fedecastellaro/Fully-Integrated-AP-Measurer/Esquemático + PCB/BOM/BOM_PROYECTO_CASTELLARO.xls

Comment | Description | LibRef | Quantity
15nF 50V X7R | C_0805 | CAP | 1
2.7nF 50V X7R | C_0805 | CAP | 1
39nF 50V X7R | C_0805 | CAP | 2
10uF 6.3V X7R | C_0805 | CAP | 5
100nF 50V X7R | C_0805 | CAP | 8
10nF 50V X7R | C_0805 | CAP | 1
18pF 50V COG | C_0805 | CAP | 2
100nF 50V X7R | C_0805 | CAP | 7
68k 5% | R_0805 | RES | 2
27k 5% | R_0805 | RES | 3
56k 5% | R_0805 | RES | 1
100k 5% | R_0805 | RES | 3
10k 5% | R_0805 | RES | 2
100k 5% | Preset | RPot SM | 2
4k7 5% | R_0805 | RES | 1
1k 5% | R_0805 | RES | 3
10k 5% | R_0805 | RES | 7
100 5% | R_0805 | RES | 1
Green Led | LED_0805 | LED | 1
LM324AM/NOPB | SOI8 | LM358M | 1
LM324AM/NOPB | SOIC14 | LM324M | 1
AD620ARZ | SOI8 | AD620 | 1
LPC1769FBD100 | LQFP100 | LPC1768FBD100 | 1
TL7660CD | SOI8 | TL7660 | 1
TPS73733DCQ | SOT-223-4 | TLV1117-33CKVURG3 | 1
ABM3C-12.000MHZ-D4Y-T | ABM3C | ABM3_CRISTAL | 1
Conector IDC MACHO VERTICAL 2x5 | Conector_TFT | Conector | 1
