fedecastellaro/Fully-Integrated-AP-Measurer/(list of files, cad)

Other CAD files:
Esquemático + PCB/Datasheets/2.2S/51-keil-Demo/Basic_scrap_r test/main.OBJ
Esquemático + PCB/Datasheets/2.2S/51-keil-Demo/Integrated_Test_requires_more_than_16K_ROM_MCU/Integrated_Test_requires_more_than_16K_ROM_MCU/main.OBJ
Esquemático + PCB/Datasheets/2.2S/51-keil-Demo/Basic_scrap_r test/font.obj
Esquemático + PCB/Datasheets/2.2S/51-keil-Demo/Integrated_Test_requires_more_than_16K_ROM_MCU/Integrated_Test_requires_more_than_16K_ROM_MCU/font.obj
Esquemático + PCB/Datasheets/2.2S/51-keil-Demo/Basic_scrap_r test/LCD.obj
Esquemático + PCB/Datasheets/2.2S/51-keil-Demo/Integrated_Test_requires_more_than_16K_ROM_MCU/Integrated_Test_requires_more_than_16K_ROM_MCU/LCD.obj
Esquemático + PCB/Datasheets/2.2S/51-keil-Demo/Basic_scrap_r test/touch.obj
Esquemático + PCB/Datasheets/2.2S/51-keil-Demo/Integrated_Test_requires_more_than_16K_ROM_MCU/Integrated_Test_requires_more_than_16K_ROM_MCU/sys.obj
Esquemático + PCB/Datasheets/2.2S/51-keil-Demo/Basic_scrap_r test/sys.obj
Esquemático + PCB/Datasheets/2.2S/51-keil-Demo/Integrated_Test_requires_more_than_16K_ROM_MCU/Integrated_Test_requires_more_than_16K_ROM_MCU/touch.obj
Esquemático + PCB/Datasheets/2.2S/51-keil-Demo/Basic_scrap_r test/STARTUP.OBJ
Esquemático + PCB/Datasheets/2.2S/51-keil-Demo/Integrated_Test_requires_more_than_16K_ROM_MCU/Integrated_Test_requires_more_than_16K_ROM_MCU/STARTUP.OBJ
