fedecastellaro/Fully-Integrated-AP-Measurer/Esquemático + PCB/TDII_ANALOG_R00.pdf

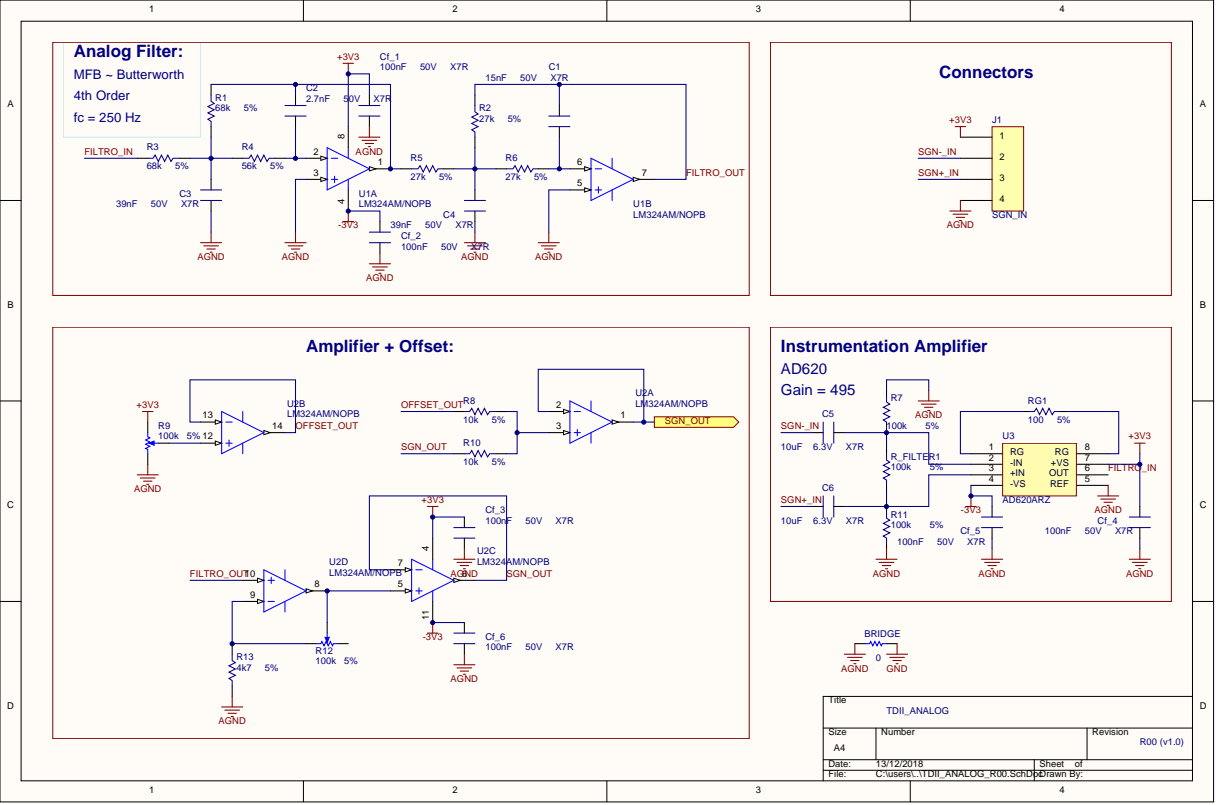
[picture p51: page 1]
