fedecastellaro/Fully-Integrated-AP-Measurer/(list of files, drawings)

Other design files:
Esquemático + PCB/TDII_ANALOG_R00.SchDoc
Esquemático + PCB/TDII_Bloques_R00.SchDoc
Esquemático + PCB/TDII_BT_R00.SchDoc
Esquemático + PCB/TDII_CPU_R00.SchDoc
Esquemático + PCB/TDII_PCB(backup)_R00.PcbDoc
Esquemático + PCB/TDII_PCB_LIB_R00.PcbLib
Esquemático + PCB/TDII_PCB_R00.PcbDoc
Esquemático + PCB/TDII_PROYECT_R00.PrjPcb
Esquemático + PCB/TDII_PWR(BackUp)_R00.SchDoc
Esquemático + PCB/TDII_PWR_R00.SchDoc
Esquemático + PCB/TDII_SCH_LIB_R00.SchLib
Esquemático + PCB/TDII_TFT_R00.SchDoc
Esquemático + PCB/TDII_WIFI_R00.SchDoc
