fedecastellaro/Fully-Integrated-AP-Measurer/Código LPC1769/TDII_TPO_Medidor_PA_v1.0/src/ILI9340.h

/*
 * ILI9340.h
 *
 *  Created on: 15 de set. de 2018
 *      Author: federico
 */

#ifndef ILI9340_H_
#define ILI9340_H_

/*
 * Display.h
 *
 *  Created on: Oct 16, 2016
 *      Author: ruben
 */
#include "board.h"

/*-------------DEFINICIONES DISPLAY---------------------*/
/*
PINS for the baseboard TD2
#define BUFFER_SIZE_SSP		100
#define MOSI_SPP			0,9
#define MISO_SPP			0,8
#define SCK_SPP				0,7
#define CS_SPP				0,11
#define DC_SPP				0,10
#define RST_SPP				0,0
#define LPCP0 				LPC_GPIO
#define TICKRATE_HZ1			4000
*/
#define BUFFER_SIZE_SSP		100
//#define TICKRATE_HZ1		4000

//#define placa // Para la configuracion de la placa de TD2
/*
//#ifndef placa
#define MOSI_SPP			0,9
#define MISO_SPP			0,8
#define SCK_SPP				0,7
#define CS_SPP				0,11
#define DC_SPP				0,10
#define RST_SPP				0,0
#define LPC_SSP				LPC_SSP1
#else
#define MOSI_SPP			0,18
#define SCK_SPP				0,15
#define CS_SPP				0,22
#define DC_SPP				0,20
#define RST_SPP				0,21
#define LPC_SSP				LPC_SSP0
#endif
*/
#define MOSI_SPP			0,18
#define MISO_SPP			0,17
#define SCK_SPP				0,15
#define CS_SPP				0,16
#define DC_SPP				0,8
#define RST_SPP				0,9
#define LPC_SSP				LPC_SSP0
#define LPCP0 				LPC_GPIO

#define mask 0x80

#define ILI9340_TFTWIDTH  240
#define ILI9340_TFTHEIGHT 320

#define ILI9340_NOP     0x00
#define ILI9340_SWRESET 0x01
#define ILI9340_RDDID   0x04
#define ILI9340_RDDST   0x09

#define ILI9340_SLPIN   0x10
#define ILI9340_SLPOUT  0x11
#define ILI9340_PTLON   0x12
#define ILI9340_NORON   0x13

#define ILI9340_RDMODE  0x0A
#define ILI9340_RDMADCTL  0x0B
#define ILI9340_RDPIXFMT  0x0C
#define ILI9340_RDIMGFMT  0x0A
#define ILI9340_RDSELFDIAG  0x0F

#define ILI9340_INVOFF  0x20
#define ILI9340_INVON   0x21
#define ILI9340_GAMMASET 0x26
#define ILI9340_DISPOFF 0x28
#define ILI9340_DISPON  0x29

#define ILI9340_CASET   0x2A
#define ILI9340_PASET   0x2B
#define ILI9340_RAMWR   0x2C
#define ILI9340_RAMRD   0x2E

#define ILI9340_PTLAR   0x30
#define ILI9340_MADCTL  0x36


#define ILI9340_MADCTL_MY  0x80
#define ILI9340_MADCTL_MX  0x40
#define ILI9340_MADCTL_MV  0x20
#define ILI9340_MADCTL_ML  0x10
#define ILI9340_MADCTL_RGB 0x00
#define ILI9340_MADCTL_BGR 0x08
#define ILI9340_MADCTL_MH  0x04

#define ILI9340_PIXFMT  0x3A

#define ILI9340_FRMCTR1 0xB1
#define ILI9340_FRMCTR2 0xB2
#define ILI9340_FRMCTR3 0xB3
#define ILI9340_INVCTR  0xB4
#define ILI9340_DFUNCTR 0xB6

#define ILI9340_PWCTR1  0xC0
#define ILI9340_PWCTR2  0xC1
#define ILI9340_PWCTR3  0xC2
#define ILI9340_PWCTR4  0xC3
#define ILI9340_PWCTR5  0xC4
#define ILI9340_VMCTR1  0xC5
#define ILI9340_VMCTR2  0xC7

#define ILI9340_RDID1   0xDA
#define ILI9340_RDID2   0xDB
#define ILI9340_RDID3   0xDC
#define ILI9340_RDID4   0xDD

#define ILI9340_GMCTRP1 0xE0
#define ILI9340_GMCTRN1 0xE1
/*
#define ILI9340_PWCTR6  0xFC

*/

// Color definitions
#define	ILI9340_BLACK   0x0000
#define	ILI9340_BLUE    0x001F
#define	ILI9340_RED     0xF800
#define	ILI9340_GREEN   0x07E0
#define ILI9340_CYAN    0x07FF
#define ILI9340_MAGENTA 0xF81F
#define ILI9340_YELLOW  0xFFE0
#define ILI9340_WHITE   0xFFFF


/*---------------PROTOTIPOS---------------------*/
void on_bt(void);
void off_bt(void);
void on_wifi(void);
void off_wifi(void);
void grilla(void);
void modo_activo(void);
void modo_inactivo(void);
void version(void);
void ppm_graph (char *num);
void printfloat( char *number);

void GPIOs_SSP_Init(void);
void SPI_Init(void);
void TFT_Init(void);
void writecommand(uint8_t);
void writedata(uint8_t);
void fillScreen(uint16_t);
void delay (unsigned long);
void SysTick_Handler (void);
void spiwrite(uint8_t);
void fillRect(int16_t x, int16_t y, int16_t w, int16_t h,  uint16_t color);
void setAddrWindow(uint16_t x0, uint16_t y0, uint16_t x1, uint16_t y1);
void testText(void) ;
void testFillScreen() ;
void write(uint8_t c) ;
void setTextSize(uint8_t s);
void setTextColor(uint16_t c);
void setCursor(int16_t x, int16_t y);
void drawChar(int16_t x, int16_t y, unsigned char c, uint16_t color, uint16_t bg, uint8_t size) ;
void drawPixel(int16_t x, int16_t y, uint16_t color);
void println( char c[]);
void printn(int);
void setRotation(uint8_t x);
void drawLine(int16_t x0, int16_t y0, int16_t x1, int16_t y1, uint16_t color) ;
void drawFastHLine(int16_t x, int16_t y, int16_t w,  uint16_t color);
void drawFastVLine(int16_t x, int16_t y, int16_t h, uint16_t color);
void testLines(uint16_t color) ;
void testFastLines(uint16_t color1, uint16_t color2) ;
void drawRect(int16_t x, int16_t y, int16_t w, int16_t h, uint16_t color);
void testFilledRects(uint16_t color1, uint16_t color2) ;
void testFilledCircles(uint8_t radius, uint16_t color);
void fillCircle(int16_t x0, int16_t y0, int16_t r, uint16_t color);
void fillCircleHelper(int16_t x0, int16_t y0, int16_t r, uint8_t cornername, int16_t delta, uint16_t color);
void testCircles(uint8_t radius, uint16_t color);
void drawCircle(int16_t x0, int16_t y0, int16_t r, uint16_t color) ;
void testTriangles(void);
void drawTriangle(int16_t x0, int16_t y0, int16_t x1, int16_t y1, int16_t x2, int16_t y2, uint16_t color);
void testFilledTriangles(void);
uint16_t Color565(uint8_t r, uint8_t g, uint8_t b) ;
void testRoundRects(void);
void drawRoundRect(int16_t x, int16_t y, int16_t w, int16_t h, int16_t r, uint16_t color);
void testFilledRoundRects(void);
void drawCircleHelper( int16_t x0, int16_t y0, int16_t r, uint8_t cornername, uint16_t color) ;
void fillTriangle(int16_t x0, int16_t y0, int16_t x1, int16_t y1, int16_t x2, int16_t y2, uint16_t color);
void fillRoundRect(int16_t x, int16_t y, int16_t w, int16_t h, int16_t r, uint16_t color) ;
void drawBitmap(int16_t x, int16_t y, const uint8_t *bitmap, int16_t w, int16_t h, uint16_t color);


int16_t height(void) ;
int16_t width(void) ;
/*---------------VARIABLES GLOBALES---------------------*/
uint16_t color;
int16_t     _width, _height;// Display w/h as modified by current rotation
int16_t cursor_x, cursor_y;
uint8_t hi,lo;
int i;
uint16_t  textcolor, textbgcolor;
uint8_t  textsize,  rotation;

typedef struct { // Data stored PER GLYPH
	uint16_t bitmapOffset;     // Pointer into GFXfont->bitmap
	uint8_t  width, height;    // Bitmap dimensions in pixels
	uint8_t  xAdvance;         // Distance to advance cursor (x axis)
	int8_t   xOffset, yOffset; // Dist from cursor pos to UL corner
} GFXglyph;

typedef struct { // Data stored for FONT AS A WHOLE:
	uint8_t  *bitmap;      // Glyph bitmaps, concatenated
	GFXglyph *glyph;       // Glyph array
	uint8_t   first, last; // ASCII extents
	uint8_t   yAdvance;    // Newline distance (y axis)
} GFXfont;

GFXfont  *gfxFont;
/*IMPORTANTES PARA TEXTO!!!*/
bool  wrap,   // If set, 'wrap' text at right edge of display
  _cp437; // If set, use correct CP437 charset (default is off)


static const unsigned char font[] ={
	0x00, 0x00, 0x00, 0x00, 0x00,
	0x3E, 0x5B, 0x4F, 0x5B, 0x3E,
	0x3E, 0x6B, 0x4F, 0x6B, 0x3E,
	0x1C, 0x3E, 0x7C, 0x3E, 0x1C,
	0x18, 0x3C, 0x7E, 0x3C, 0x18,
	0x1C, 0x57, 0x7D, 0x57, 0x1C,
	0x1C, 0x5E, 0x7F, 0x5E, 0x1C,
	0x00, 0x18, 0x3C, 0x18, 0x00,
	0xFF, 0xE7, 0xC3, 0xE7, 0xFF,
	0x00, 0x18, 0x24, 0x18, 0x00,
	0xFF, 0xE7, 0xDB, 0xE7, 0xFF,
	0x30, 0x48, 0x3A, 0x06, 0x0E,
	0x26, 0x29, 0x79, 0x29, 0x26,
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
	0x40, 0x51, 0x4A, 0x44, 0x40,
	0x40, 0x44, 0x4A, 0x51, 0x40,
	0x00, 0x00, 0xFF, 0x01, 0x03,
	0xE0, 0x80, 0xFF, 0x00, 0x00,
	0x08, 0x08, 0x6B, 0x6B, 0x08,
	0x36, 0x12, 0x36, 0x24, 0x36,
	0x06, 0x0F, 0x09, 0x0F, 0x06,
	0x00, 0x00, 0x18, 0x18, 0x00,
	0x00, 0x00, 0x10, 0x10, 0x00,
	0x30, 0x40, 0xFF, 0x01, 0x01,
	0x00, 0x1F, 0x01, 0x01, 0x1E,
	0x00, 0x19, 0x1D, 0x17, 0x12,
	0x00, 0x3C, 0x3C, 0x3C, 0x3C,
	0x00, 0x00, 0x00, 0x00, 0x00  // #255 NBSP
};

uint8_t rotation;
uint8_t *buffer;// no se por donde ponerlo
#define pgm_read_byte(addr) (*(const unsigned char *)(addr))
#define _swap_int16_t(a, b) { int16_t t = a; a = b; b = t; }
#define abs(x) ((x)>0?(x):-(x))
#define min(x,y) ( (x) > (y)  ? (y) : (x) )



#endif /* ILI9340_H_ */
