fedecastellaro/Fully-Integrated-AP-Measurer/Código LPC1769/TDII_TPO_Medidor_PA_v1.0/src/presentacion.h

const unsigned char GIBIO_LOGO [] ={
		0x0,0x0,0x0,0x0,0x0,0x0,0x0,0x0,0x0,0x0,0x0,0x0,0x0,0x0,0x0,0x0,0x0,0x0,0x0,0x0,0x0,0x0,0x0,0x0,0x0,0x0,0x0,0x0,0x0,0x0,0x0,0x0,0x0,0x0,0x0,0x0,0x0,0x0,
		0x0,0x0,0x0,0x0,0x0,0xf,0x0,0x0,0x0,0x0,0x0,0x3f,0x0,0x0,0x0,0x0,0x0,0x0,0x0,0x0,0x0,0x0,0x0,0x0,0x0,0x0,0x0,0x0,0x0,0x0,0x0,0x0,0x0,0x0,0x0,0x0,0x0,0x0,
		0x0,0x0,0x0,0x0,0x0,0x1f,0x80,0x0,0x0,0x0,0x0,0x7f,0x80,0x0,0x0,0x0,0x0,0x0,0x0,0x0,0x0,0x0,0x0,0x0,0x0,0x0,0x0,0x0,0x0,0x0,0x0,0x0,0x0,0x0,0x0,0x0,0x0,0x0,
		0x0,0x0,0x0,0x0,0x0,0x3f,0xc0,0x0,0x0,0x0,0x0,0xff,0xc0,0x0,0x0,0x0,0x0,0x0,0x0,0x0,0x0,0x0,0x0,0x0,0x0,0x0,0x0,0x0,0x0,0x0,0x0,0x0,0x0,0x0,0x0,0x0,0x0,0x0,
		0x0,0x0,0x0,0x0,0x0,0x3f,0xe0,0x0,0x0,0x0,0x0,0xff,0xc0,0x0,0x0,0x0,0x0,0x0,0x0,0x0,0x0,0x0,0x0,0x0,0x0,0x0,0x0,0x0,0x0,0x0,0x0,0x0,0x0,0x0,0x0,0x0,0x0,0x0,
		0x0,0x0,0x0,0x0,0x0,0x3f,0xf0,0x0,0x0,0x0,0x0,0xff,0xc0,0x0,0x0,0x0,0x0,0x0,0x0,0x0,0x0,0x0,0x0,0x0,0x0,0x0,0x0,0x0,0x0,0x0,0x0,0x0,0x0,0x0,0x0,0x0,0x0,0x0,
		0x0,0x0,0x0,0x0,0x0,0x7f,0xf0,0x0,0x0,0x0,0x1,0xff,0xc0,0x0,0x0,0x0,0x0,0x0,0x0,0x0,0x0,0x0,0x0,0x0,0x0,0x0,0x0,0x0,0x0,0x0,0x0,0x0,0x0,0x0,0x0,0x0,0x0,0x0,
		0x0,0x0,0x0,0x0,0x0,0x7f,0xf0,0x0,0x0,0x0,0x1,0xff,0xc0,0x0,0x0,0x0,0x0,0x0,0x0,0x0,0x0,0x0,0x0,0x0,0x0,0x0,0x0,0x0,0x0,0x0,0x0,0x0,0x0,0x0,0x0,0x0,0x0,0x0,
		0x0,0x0,0x0,0x0,0x0,0x7f,0xf0,0x0,0x0,0x0,0x1,0xff,0xc0,0x0,0x0,0x0,0x0,0x0,0x0,0x0,0x0,0x0,0x0,0x0,0x0,0x0,0x0,0x0,0x0,0x0,0x0,0x0,0x0,0x0,0x0,0x0,0x0,0x0,
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
		0x0,0xf,0xfc,0x13,0xc6,0xfe,0x0,0x0,
		0x0,0x7,0xfe,0x57,0xc7,0xfe,0x0,0x0,
		0x0,0x7,0xfe,0x47,0xef,0xfc,0x0,0x0,
		0x0,0x3,0xff,0x67,0xef,0xf8,0x0,0x0,
		0x0,0x1,0xff,0xe7,0xff,0xf0,0x0,0x0,
		0x0,0x0,0xff,0xe7,0xff,0xe0,0x0,0x0,
		0x0,0x0,0x3f,0xff,0xff,0xc0,0x0,0x0,
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
		};
