fedecastellaro/Fully-Integrated-AP-Measurer/Código LPC1769/TDII_TPO_Medidor_PA_v1.0/src/PULSO.c

/*
 * PULSO.c
 *
 *  Created on: 4 de dic. de 2018
 *      Author: root
 */
#include "PULSO.h"

#define VALOR_UMBRAL	400
#define FCLK_TIMER2		25000000

#define MINIMO_ENTRE_PULSO 0.5 //seg
#define MAXIMO_ENTRE_PULSO 1.4 //seg
#define PPM		60
